bart6114/that-paper-plane-launcher/src/data/assembly_seed.3mf

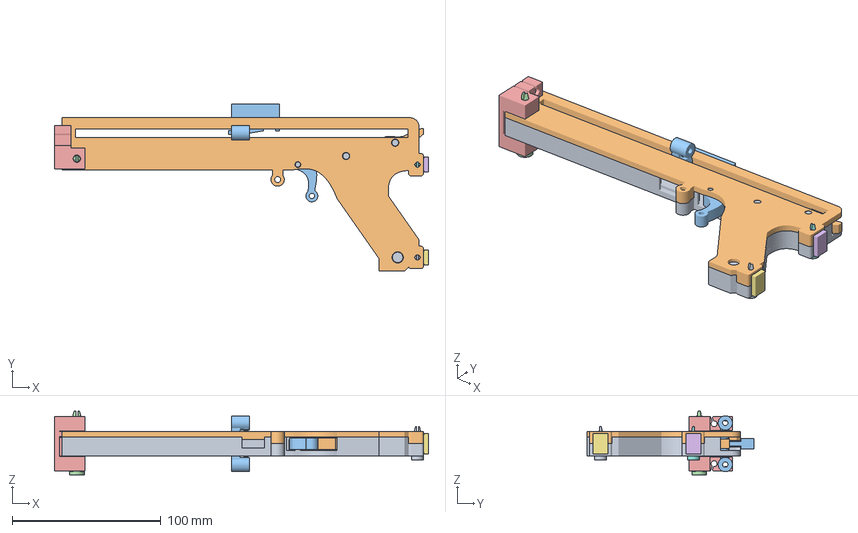
[picture p1: CAD file, 2026-10-14]
src/data/assembly_seed.3mf
251.4 x 112.5 x 43.0 mm
Base
Cover
Finger_Trigger
Front_Lock_Pin_Lower
Front_Anchor
Rear_Key
Grip_Key
Rear_Keeper_Pin
Grip_Keeper_Pin
Retrofit_Sear
Retrofit_Slider
