bart6114/that-paper-plane-launcher/print/Launcher_P1S.3mf

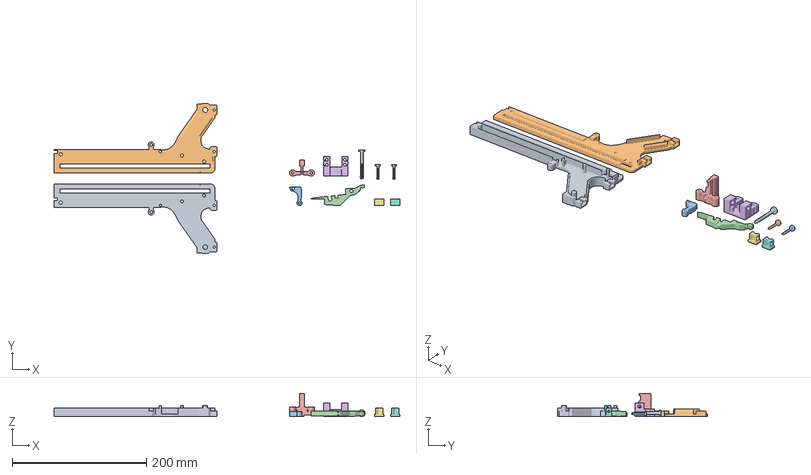
[picture p2: CAD file, 2026-10-14]
print/Launcher_P1S.3mf
516.2 x 223.2 x 34.4 mm
Base
Cover
Finger_Trigger
Retrofit_Sear
Retrofit_Slider
Front_Anchor
Rear_Key
Grip_Key
Front_Lock_Pin_Lower
Rear_Keeper_Pin
Grip_Keeper_Pin
