bart6114/that-paper-plane-launcher/print/parts/Rear_Key_P1S.3mf

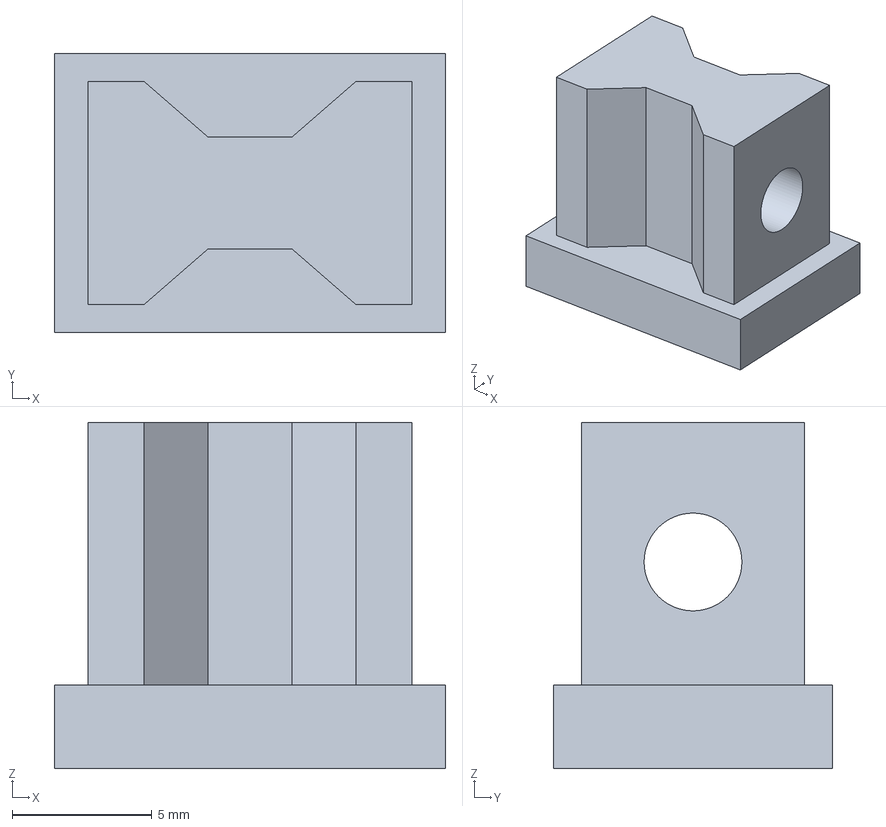
[picture p3: CAD file, 2026-10-14]
print/parts/Rear_Key_P1S.3mf
14.0 x 10.0 x 12.4 mm
