bart6114/that-paper-plane-launcher/print/parts/Finger_Trigger_P1S.3mf

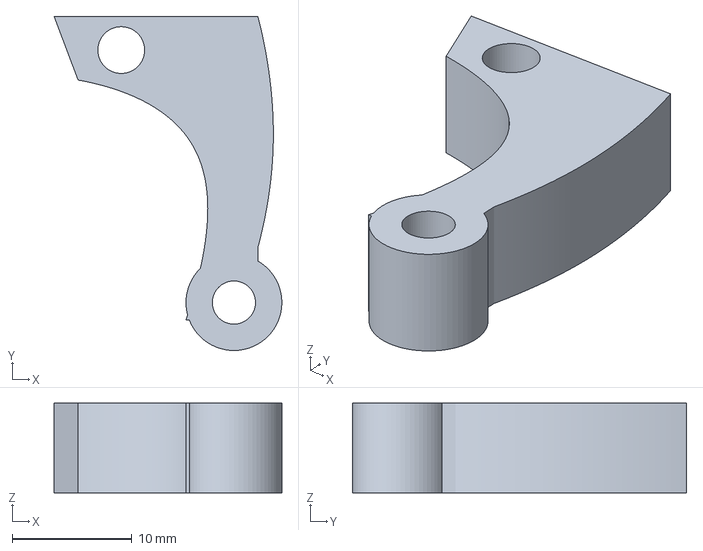
[picture p4: CAD file, 2026-10-14]
print/parts/Finger_Trigger_P1S.3mf
19.0 x 27.9 x 7.50 mm
