bart6114/that-paper-plane-launcher/print/parts/Rear_Keeper_Pin_P1S.3mf

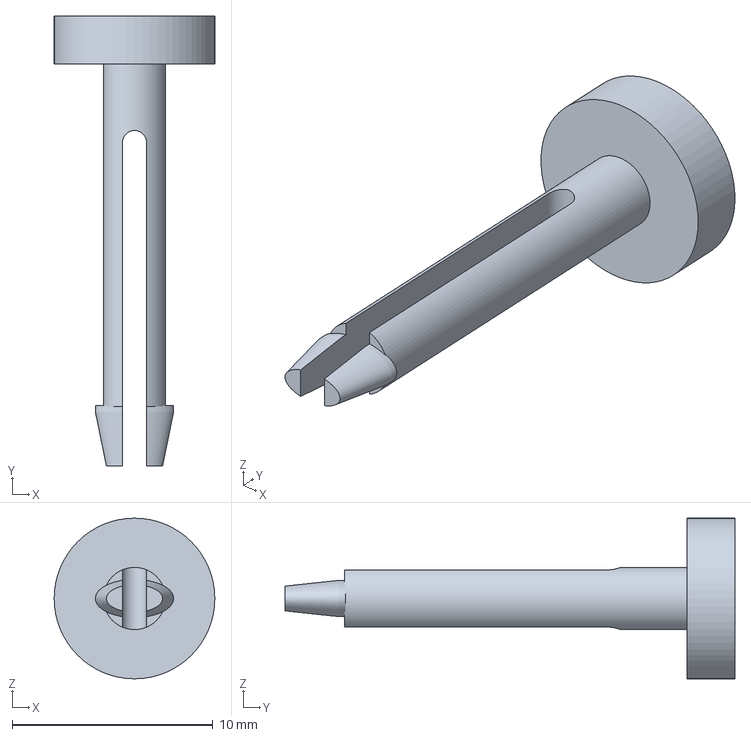
[picture p5: CAD file, 2026-10-14]
print/parts/Rear_Keeper_Pin_P1S.3mf
8.00 x 22.4 x 8.00 mm
