bart6114/that-paper-plane-launcher/print/parts/Front_Anchor_P1S.3mf

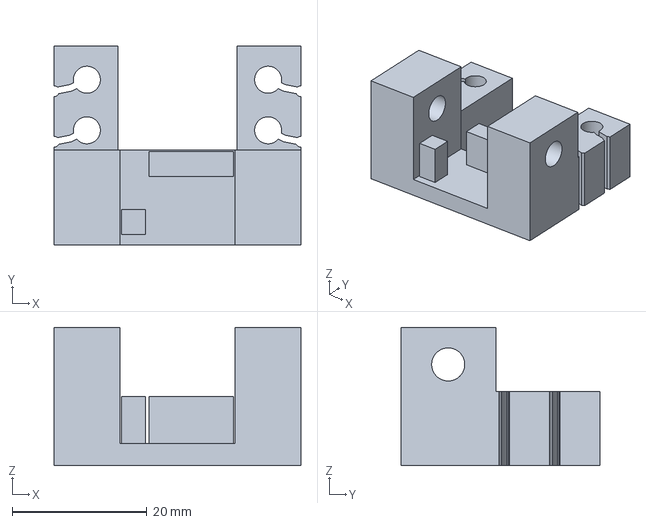
[picture p6: CAD file, 2026-10-14]
print/parts/Front_Anchor_P1S.3mf
36.6 x 29.5 x 20.5 mm
