bart6114/that-paper-plane-launcher/print/parts/Cover_P1S.3mf

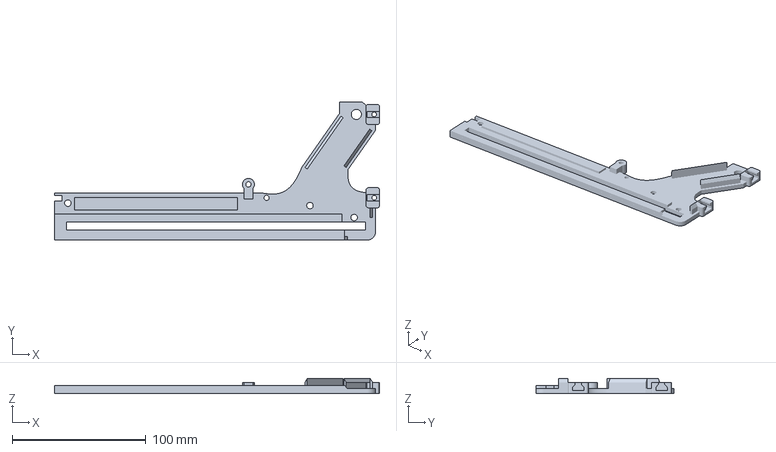
[picture p7: CAD file, 2026-10-14]
print/parts/Cover_P1S.3mf
243.0 x 103.2 x 11.3 mm
