bart6114/that-paper-plane-launcher/print/parts/Retrofit_Sear_P1S.3mf

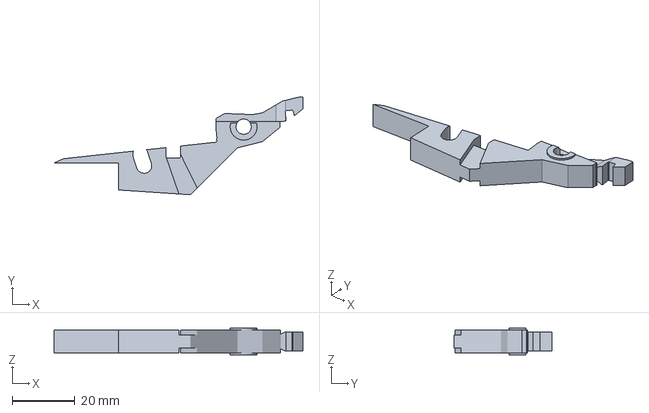
[picture p8: CAD file, 2026-10-14]
print/parts/Retrofit_Sear_P1S.3mf
79.7 x 31.2 x 8.50 mm
