bart6114/that-paper-plane-launcher/print/parts/Retrofit_Slider_P1S.3mf

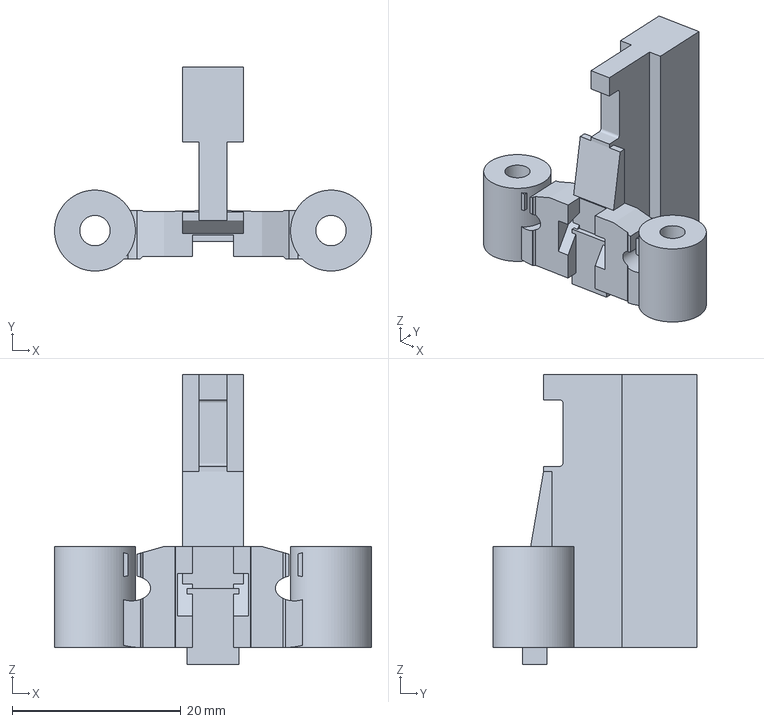
[picture p9: CAD file, 2026-10-14]
print/parts/Retrofit_Slider_P1S.3mf
37.6 x 24.2 x 34.4 mm
