bart6114/that-paper-plane-launcher/print/parts/Base_P1S.3mf

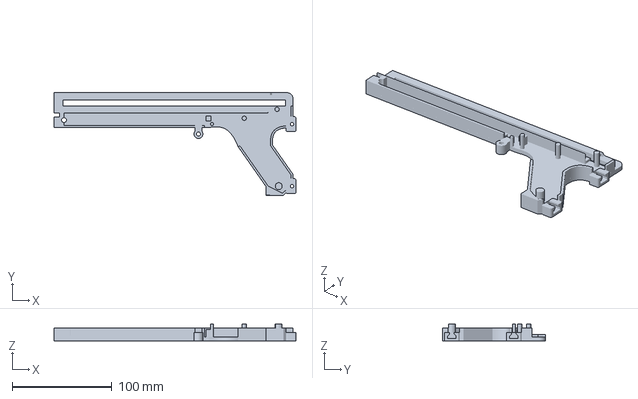
[picture p10: CAD file, 2026-10-14]
print/parts/Base_P1S.3mf
243.0 x 103.2 x 16.6 mm
