bart6114/that-paper-plane-launcher/print/parts/Front_Lock_Pin_Lower_P1S.3mf

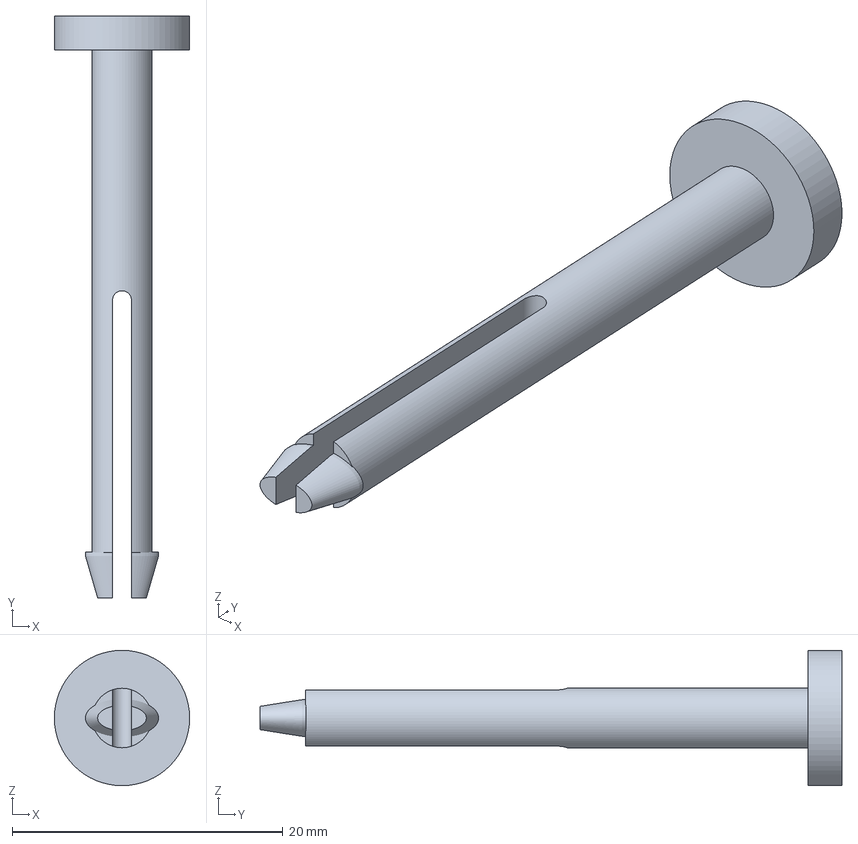
[picture p11: CAD file, 2026-10-14]
print/parts/Front_Lock_Pin_Lower_P1S.3mf
10.0 x 43.0 x 10.0 mm
