bart6114/that-paper-plane-launcher/(list of files, cad)

Other CAD files:
src/data/accepted_assembly.3mf
print/parts/Grip_Key_P1S.3mf
print/parts/Grip_Keeper_Pin_P1S.3mf
