bart6114/that-paper-plane-launcher/docs/body-changes.png

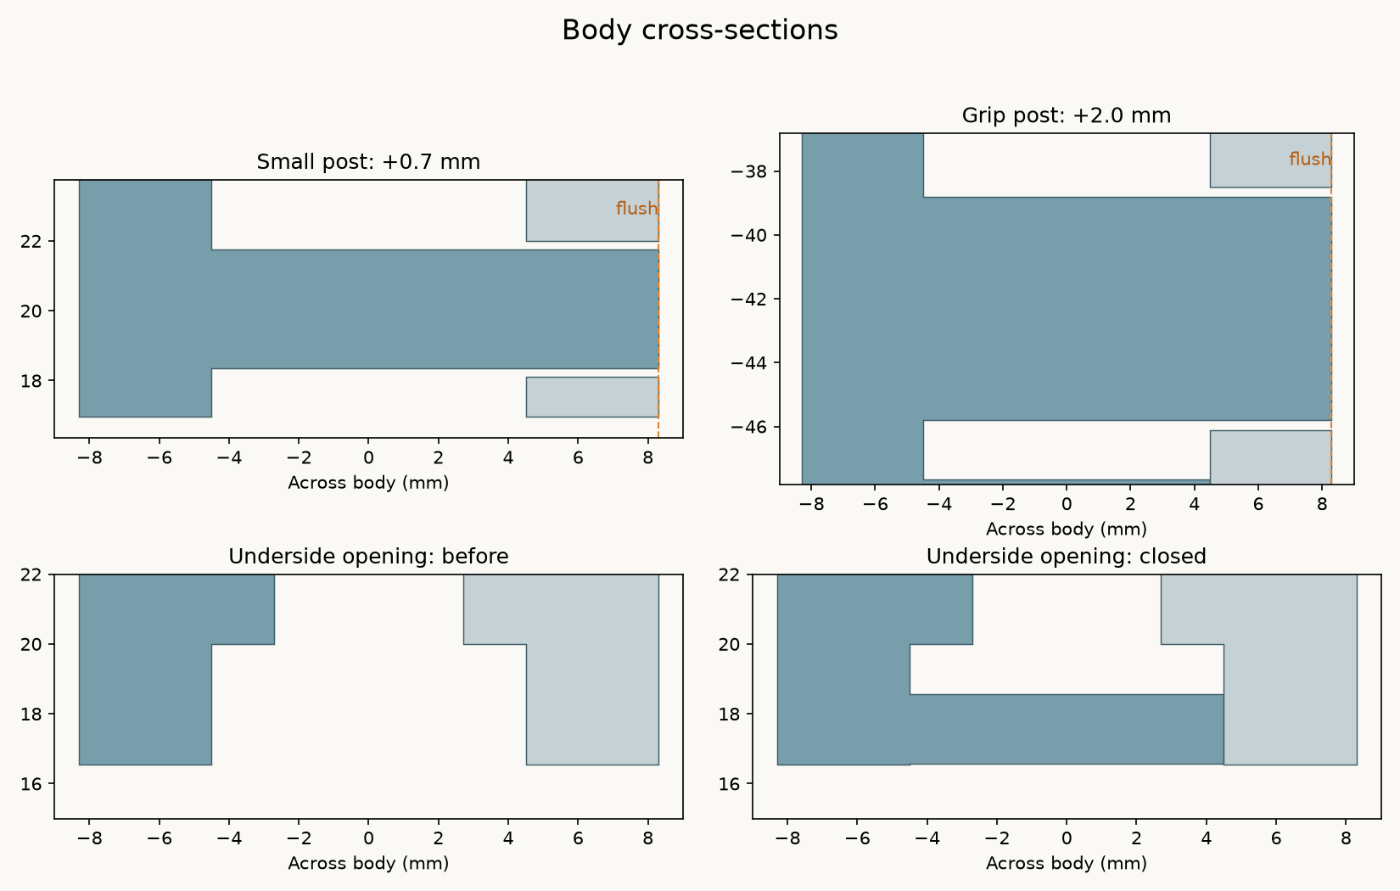
docs/body-changes.png
