bart6114/that-paper-plane-launcher/(commit log)

2026-10-14 Preserve launcher model, reproducible build and verified print layouts
    [Base_Only_P1S.3mf, Launcher_P1S.3mf, Slider_Only_P1S.3mf, accepted_assembly.3mf, assembly_seed.3mf]
2026-10-14 Provide a complete set of individual-part print projects
    [Base_Only_P1S.3mf, Base_P1S.3mf, Cover_P1S.3mf, Finger_Trigger_P1S.3mf, Front_Anchor_P1S.3mf, Front_Lock_Pin_Lower_P1S.3mf, Grip_Keeper_Pin_P1S.3mf, Grip_Key_P1S.3mf]
